Raphael-Boichot/Game-Boy-camera-sniffer/PCB/PCB_2023-09-18.png

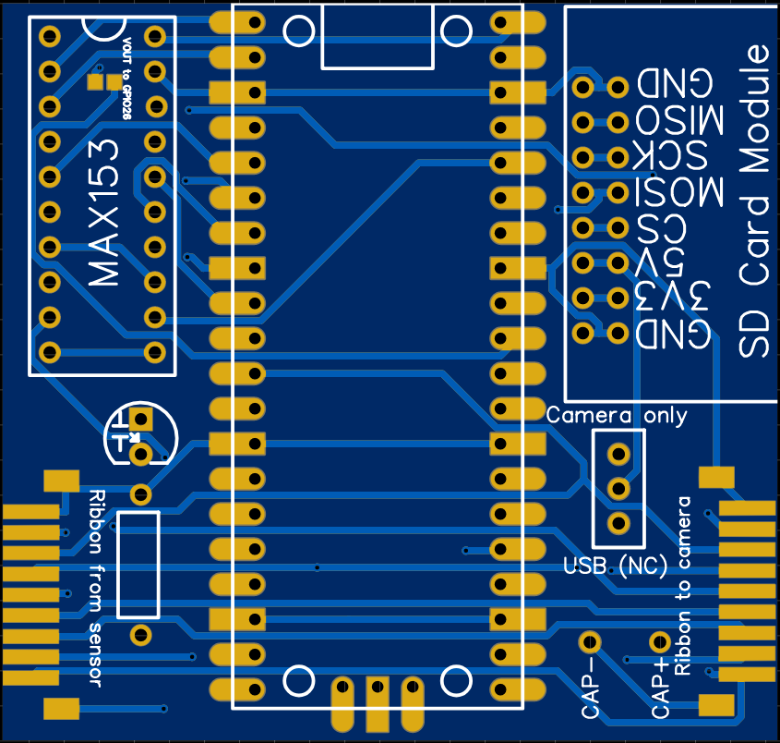
PCB/PCB_2023-09-18.png
