Raphael-Boichot/Game-Boy-camera-sniffer/PCB/Schematic_MAX153_interceptor_2023-08-23.pdf

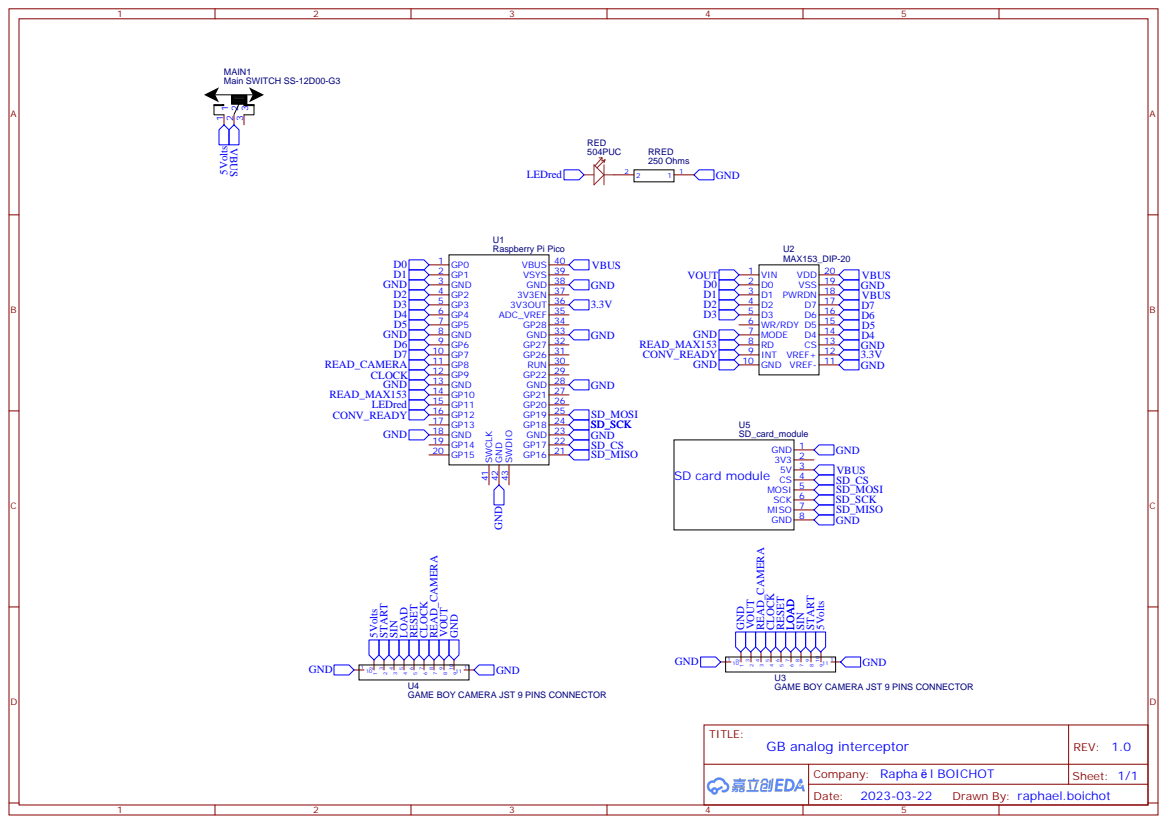
[picture p8: page 1]

GAME BOY CAMERA JST 9 PINS CONNECTOR

Drawn By: raphael.boichot
