Raphael-Boichot/Game-Boy-camera-sniffer/(list of files, drawings)

Other design files:
PCB/PCB_MAX153_interceptor_2023-09-18.json
PCB/SCH_MAX153_interceptor_2023-04-02.json
