Raphael-Boichot/Game-Boy-camera-sniffer/(commit log)

2023-03-15 PIO version, debug in progress, DMA not working
2023-04-02 updated PCB
    [PCB_PCB_MAX153_interceptor_2023-04-02.json, SCH_MAX153_interceptor_2023-04-02.json]
2023-09-18 PCB update
    [PCB_MAX153_interceptor_2023-04-02_2023-09-18.json]
